nzottmann/postcardscanner-hardware/README.md

## Hardware files for postcardscanner

License: CC-BY-SA-4.0

- 3D CAD, Fusion360 and STEP
- 3D printing files, 3MF
- Hardware BOM
- KiCAD files for custom PCB
- Pictures

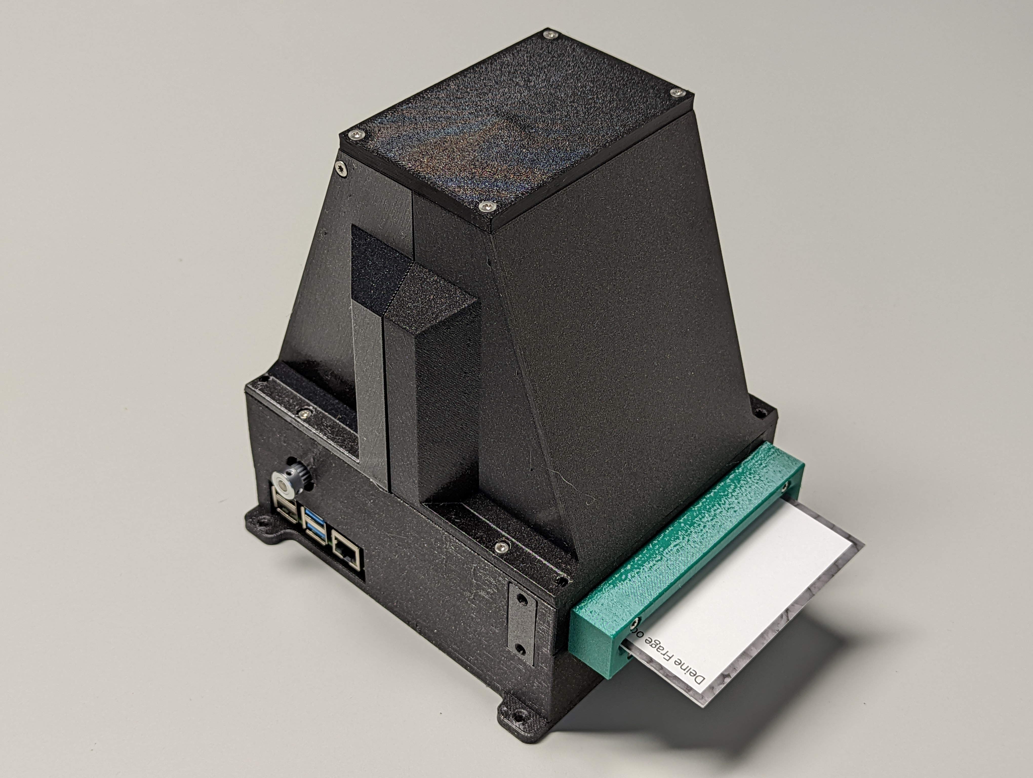
[picture p1: pictures/scanner_17.jpg]
scanner

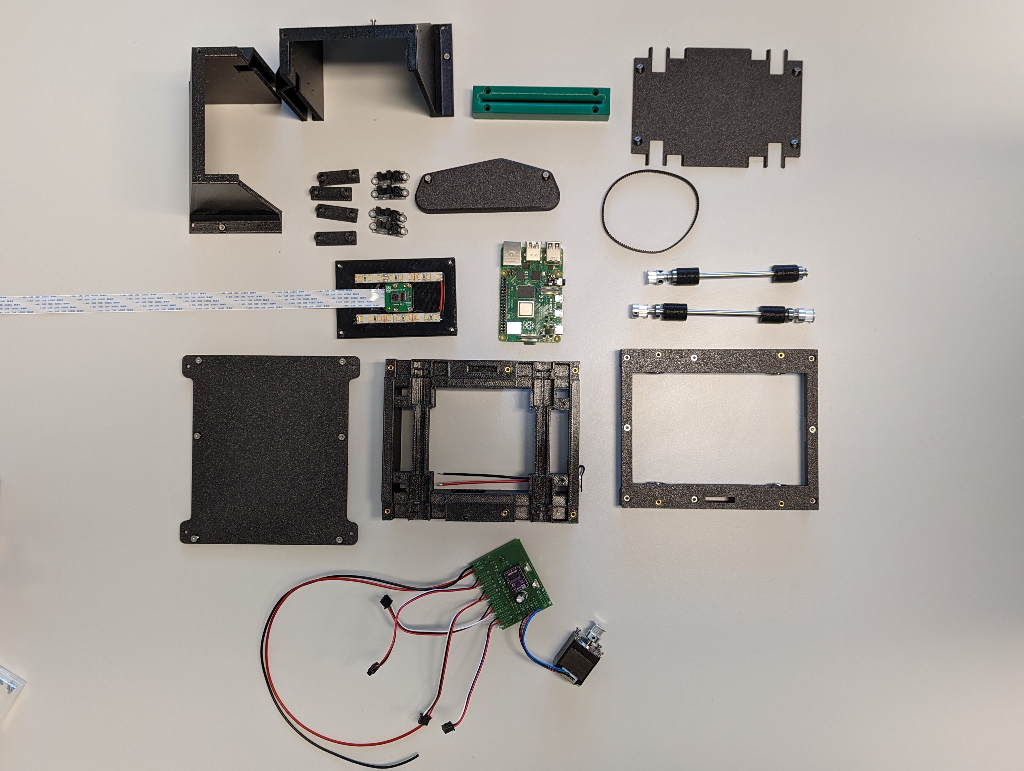
[picture p2: pictures/scanner_01.jpg]
parts
