nzottmann/postcardscanner-hardware/pictures/scanner_02.jpg

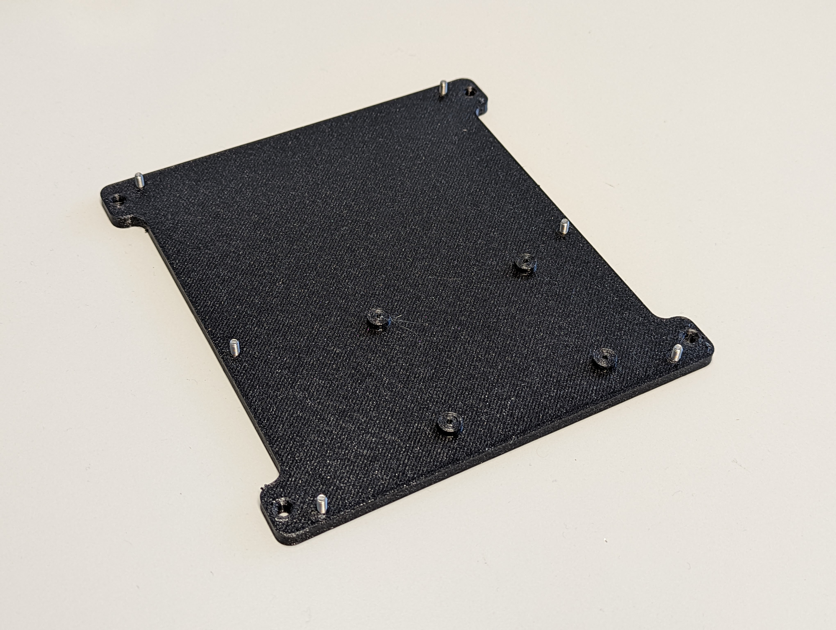
pictures/scanner_02.jpg
