nzottmann/postcardscanner-hardware/pictures/scanner_03.jpg

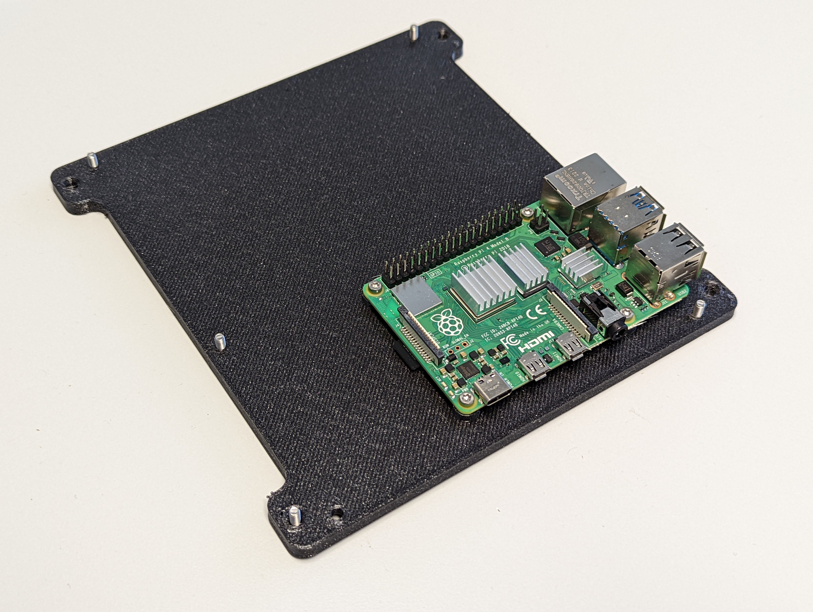
pictures/scanner_03.jpg
