nzottmann/postcardscanner-hardware/pictures/scanner_04.jpg

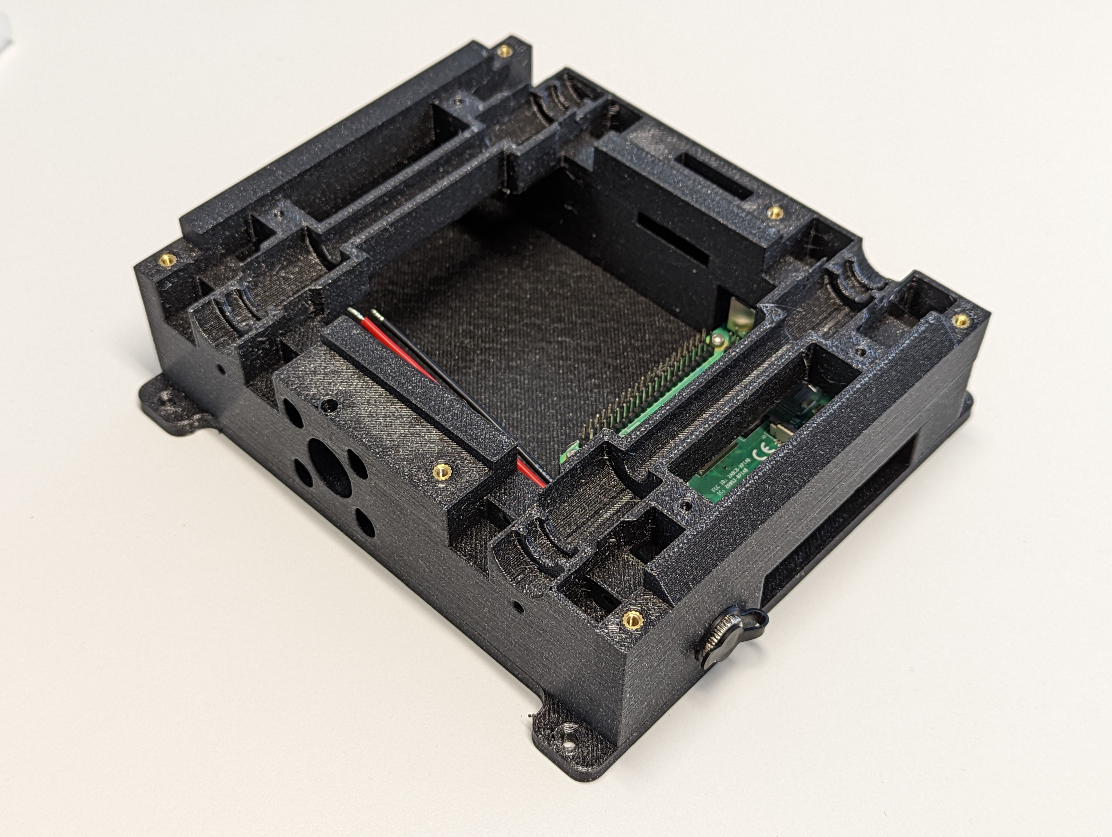
pictures/scanner_04.jpg
