nzottmann/postcardscanner-hardware/pictures/scanner_05.jpg

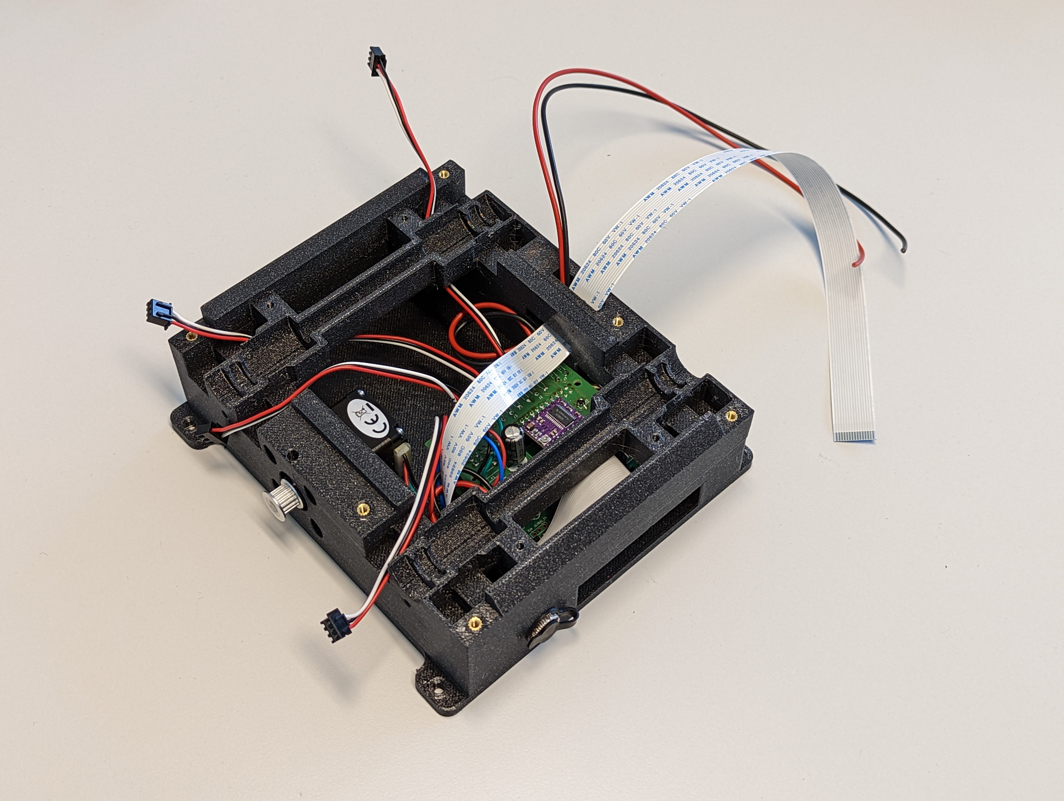
pictures/scanner_05.jpg
