nzottmann/postcardscanner-hardware/pictures/scanner_06.jpg

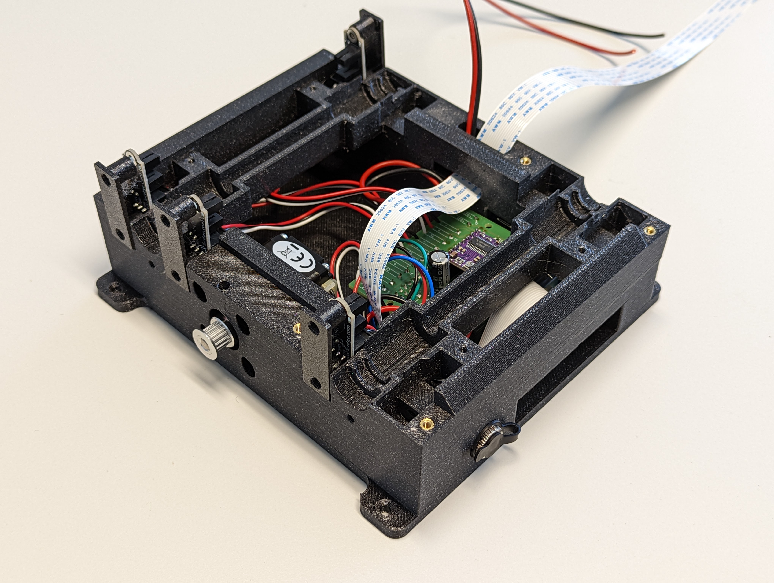
pictures/scanner_06.jpg
