nzottmann/postcardscanner-hardware/pictures/scanner_07.jpg

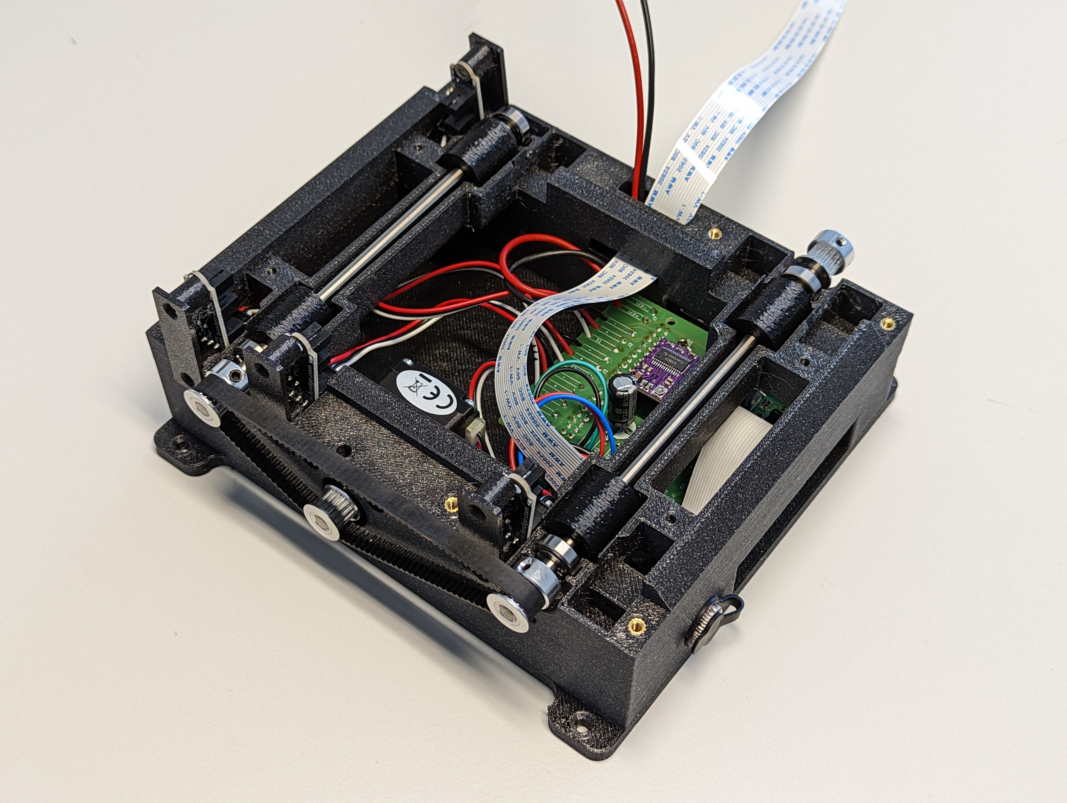
pictures/scanner_07.jpg
