nzottmann/postcardscanner-hardware/pictures/scanner_08.jpg

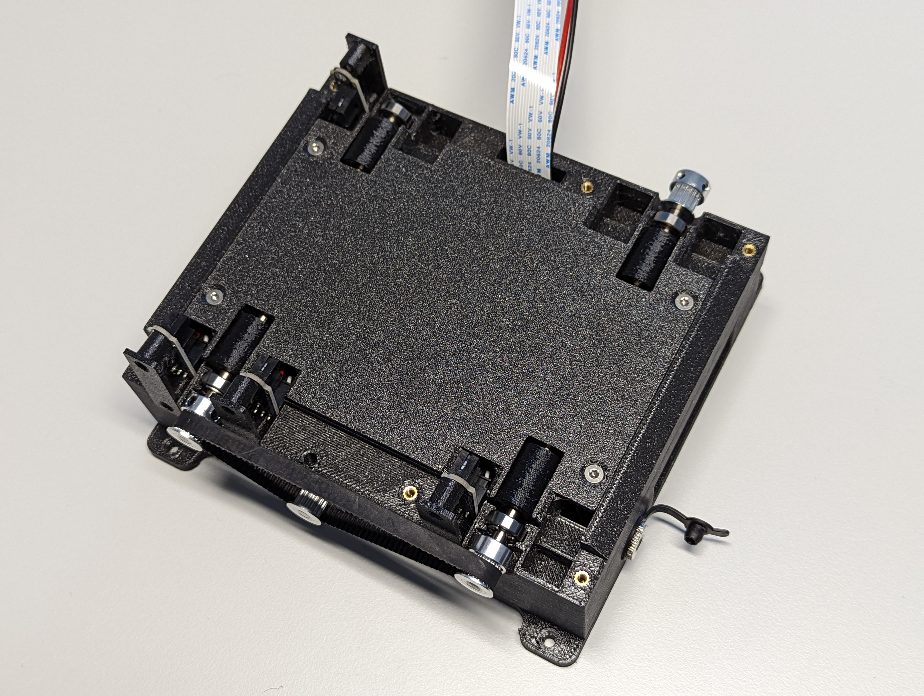
pictures/scanner_08.jpg
