nzottmann/postcardscanner-hardware/pictures/scanner_09.jpg

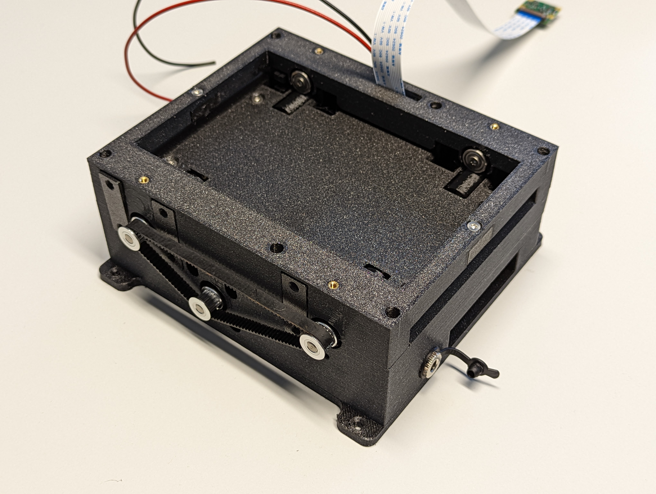
pictures/scanner_09.jpg
