nzottmann/postcardscanner-hardware/pictures/scanner_10.jpg

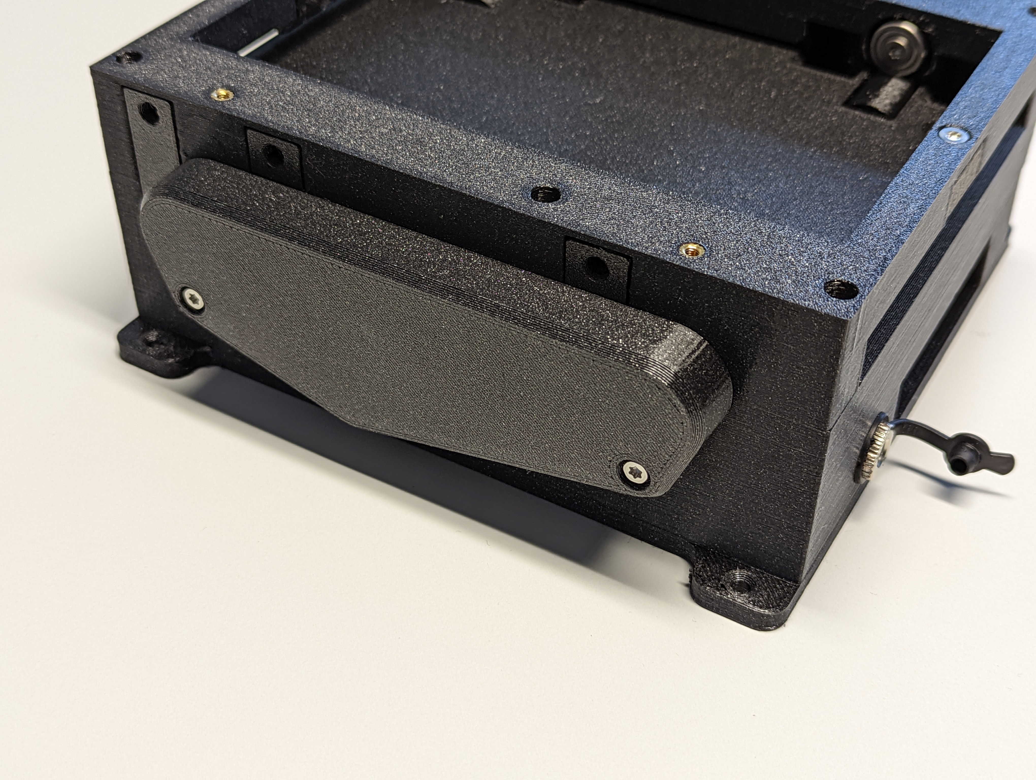
pictures/scanner_10.jpg
