nzottmann/postcardscanner-hardware/pictures/scanner_11.jpg

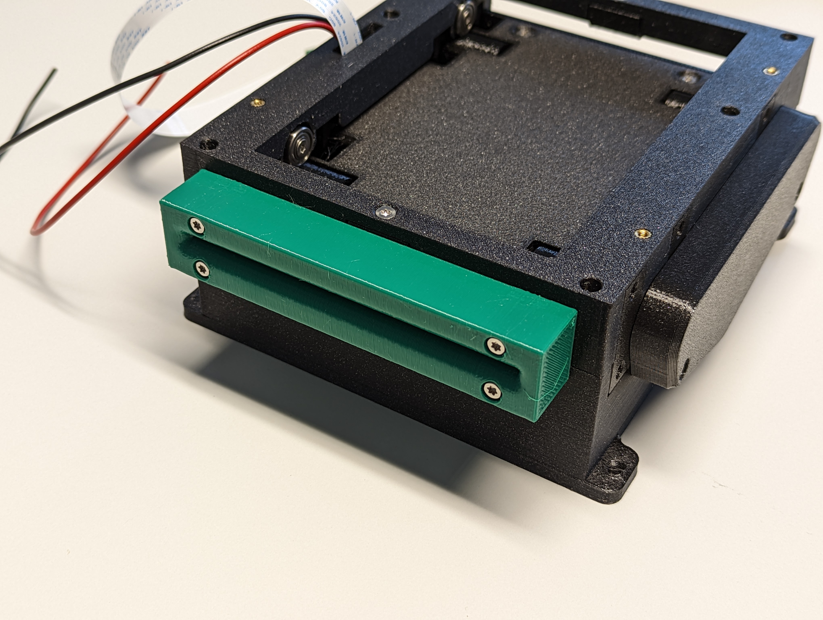
pictures/scanner_11.jpg
