nzottmann/postcardscanner-hardware/pictures/scanner_12.jpg

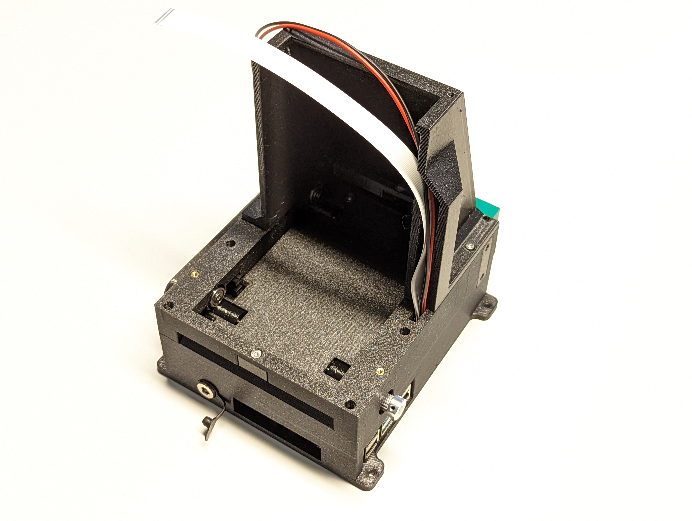
pictures/scanner_12.jpg
