nzottmann/postcardscanner-hardware/pictures/scanner_13.jpg

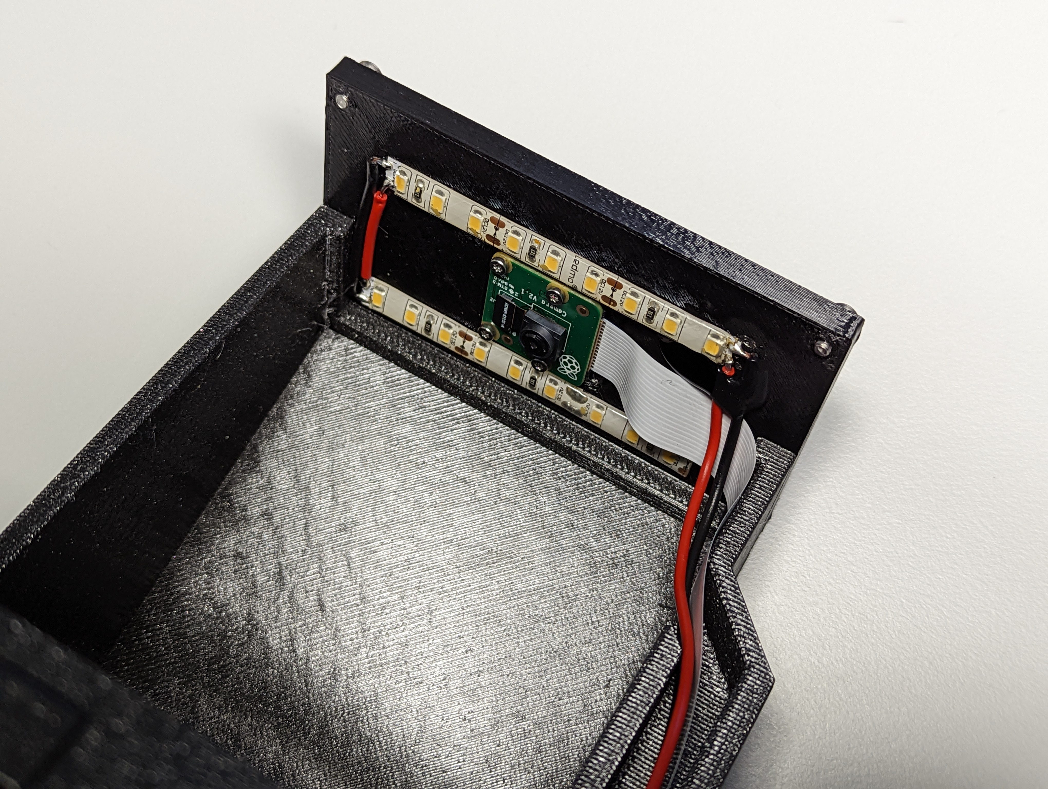
pictures/scanner_13.jpg
