nzottmann/postcardscanner-hardware/pictures/scanner_14.jpg

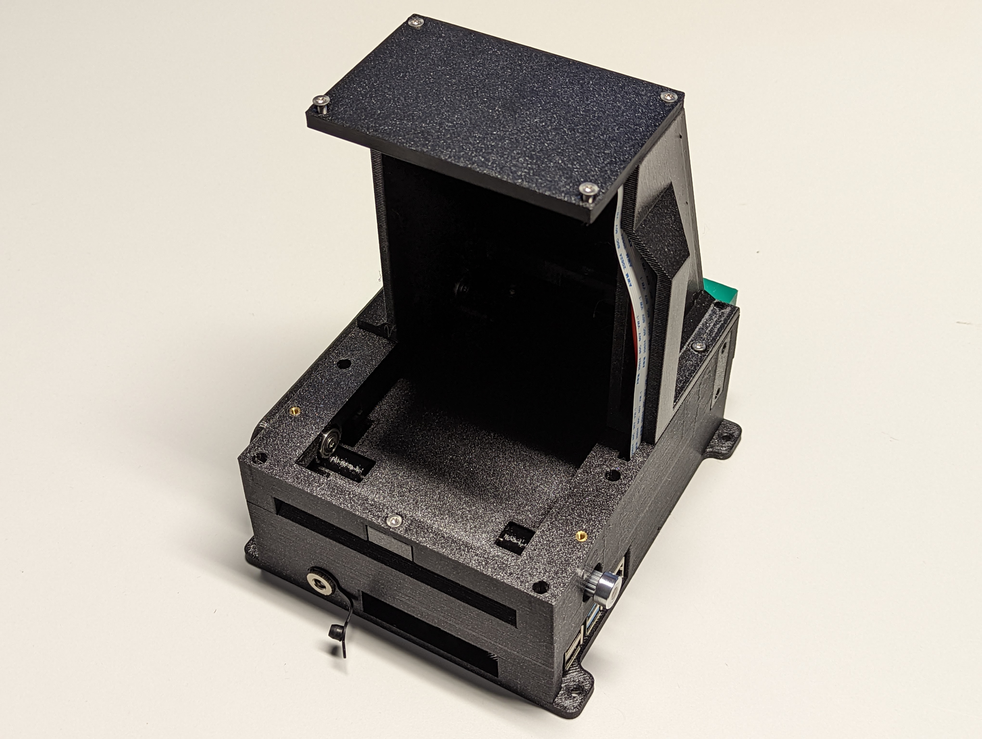
pictures/scanner_14.jpg
