nzottmann/postcardscanner-hardware/pictures/scanner_15.jpg

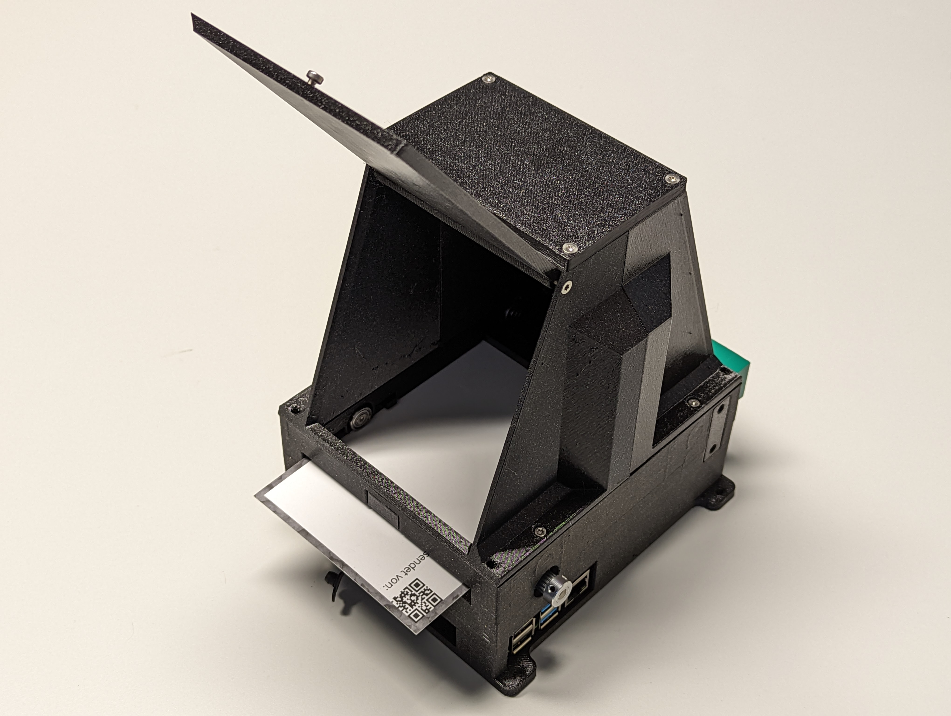
pictures/scanner_15.jpg
