nzottmann/postcardscanner-hardware/pictures/scanner_16.jpg

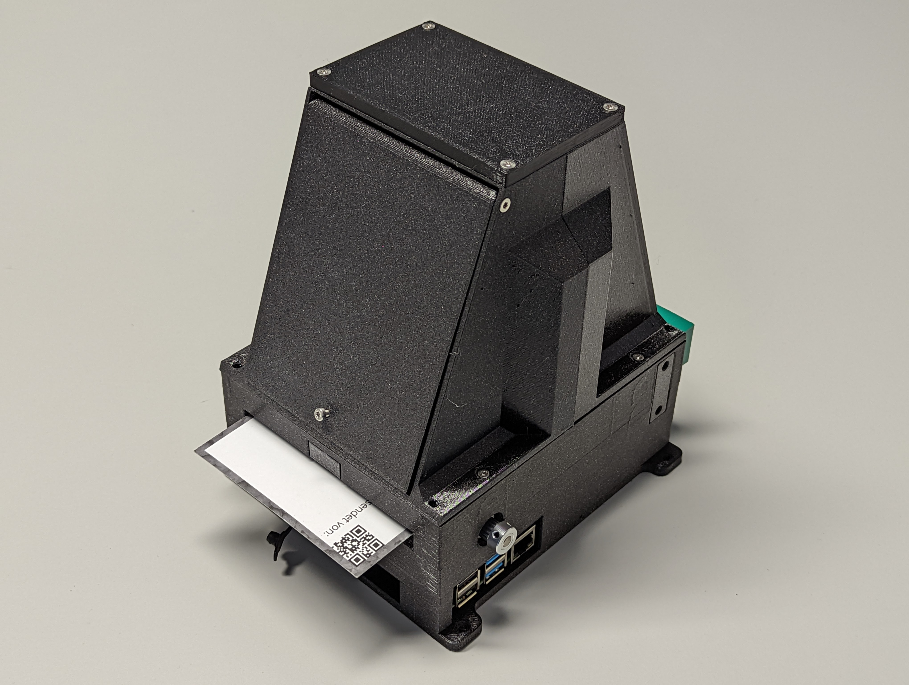
pictures/scanner_16.jpg
