nzottmann/postcardscanner-hardware/hardware/BOM.md

# Postcardscanner Bill of Materials

## 3D printed Parts

For printing, Prusament PETG and a Prusa printer with a 0.6mm nozzle is recommended. Use supports where necessary.

See 3d construction file for placment of these parts:

- base
- frame-bot (needs supports)
- frame-bot-cover
- frame-top
- 4x sensor cover
- feeder
- belt-cover
- camera
  - camera-mount
  - wall-front
  - wall-back
  - wall-back-door
- 4x roller (use TPU, FilaFlexible40 recommended)

## Mechanical

- Misumi
  - 8x bearings 695DD1 13x5x4mm RS/2RS
  - 1x axis PSFMRR5-140-B2-S18.4
  - 1x axis PSFMRR5-156.4-B18.4-S18.4
  - 4x retainer NETWS4
  - 1x belt GBN2502GT-60 2GT 6mm 250mm
- Amazon
  - 4x Pulley GT2 20 teeth for 5mm shaft, 6mm belt
  - Ruthex M3 brass inserts
- stepperonline
  - Nema 11 Bipolar 1.8deg 7Ncm 28x28x31mm
- Screws
  - ISO 14580 TX M2.5 * 6
  - ISO 14580 TX M3 * 6, 10, 16, 20
  - ISO 10642 TX M3 * 6, 10

## Electrical

- Raspberry Pi Camera v2
- Custom connection PCB (see KiCAD files)
- DRV8825 stepper drivers
- Camera flex cable 50cm
- 4x optical endstop
- 12V LED stripe, ~20cm
- Cable
