nzottmann/postcardscanner-hardware/hardware/3d printing/belt-cover.3mf

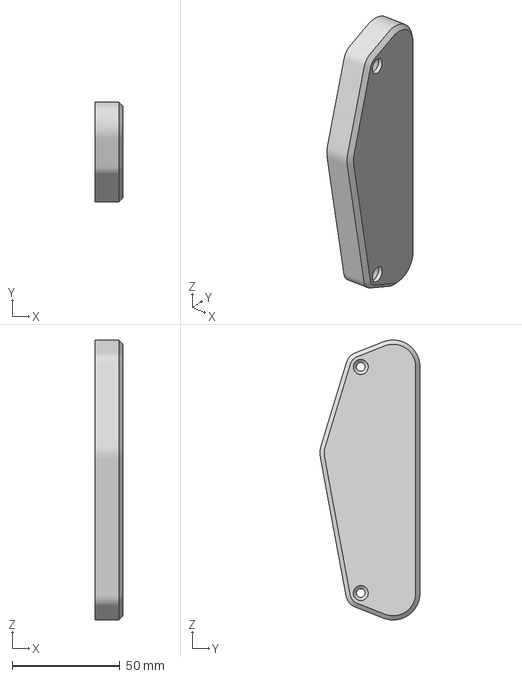
[picture p18: CAD file, 2022-12-04]
hardware/3d printing/belt-cover.3mf
13.2 x 46.4 x 130.0 mm
