nzottmann/postcardscanner-hardware/kicad/postcardscanner.step

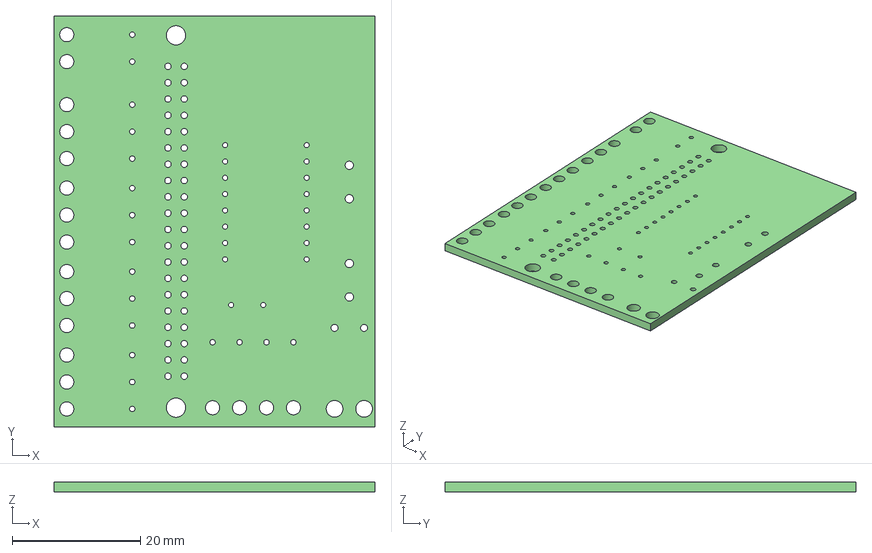
[picture p19: CAD file, 2022-12-04]
kicad/postcardscanner.step
50.0 x 64.0 x 1.60 mm
