nzottmann/postcardscanner-hardware/hardware/3d printing/feeder.3mf

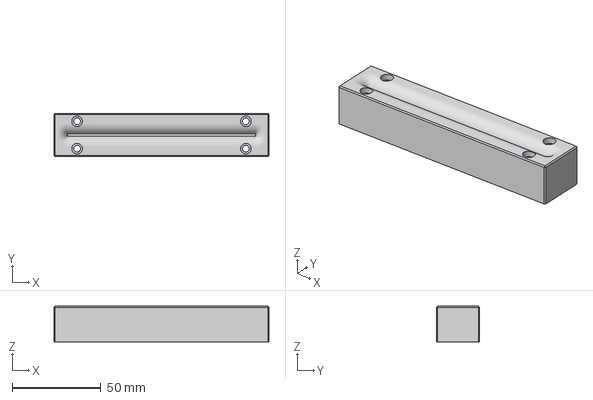
[picture p20: CAD file, 2022-12-04]
hardware/3d printing/feeder.3mf
121.0 x 24.4 x 20.0 mm
