nzottmann/postcardscanner-hardware/hardware/3d printing/roller.3mf

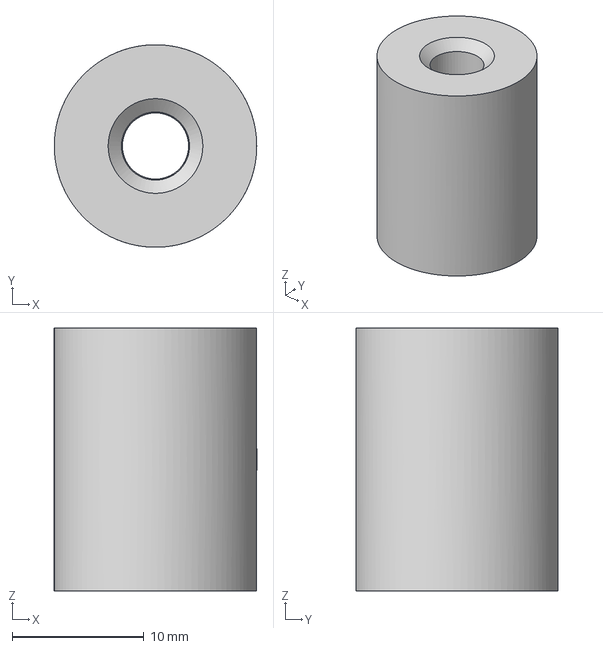
[picture p22: CAD file, 2022-12-04]
hardware/3d printing/roller.3mf
15.4 x 15.4 x 20.0 mm
