nzottmann/postcardscanner-hardware/hardware/3d printing/wall-back-door.3mf

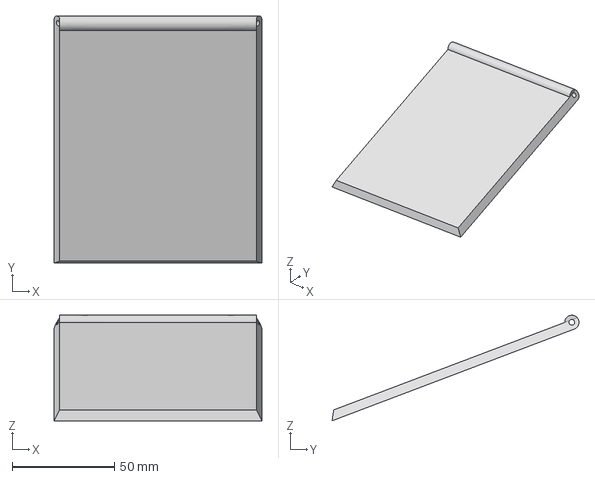
[picture p23: CAD file, 2022-12-04]
hardware/3d printing/wall-back-door.3mf
101.7 x 120.8 x 51.7 mm
