nzottmann/postcardscanner-hardware/hardware/3d printing/frame-bot.3mf

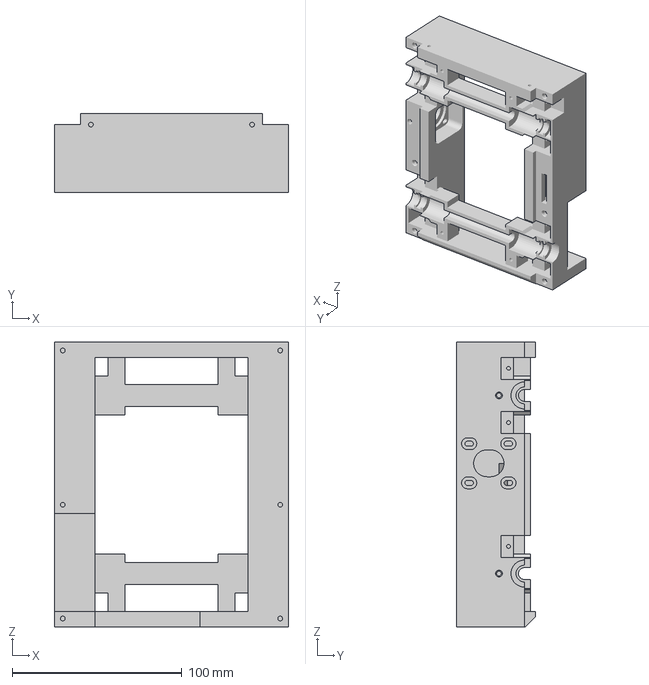
[picture p24: CAD file, 2022-12-04]
hardware/3d printing/frame-bot.3mf
138.2 x 46.5 x 168.0 mm
