nzottmann/postcardscanner-hardware/hardware/3d printing/frame-bot-cover.3mf

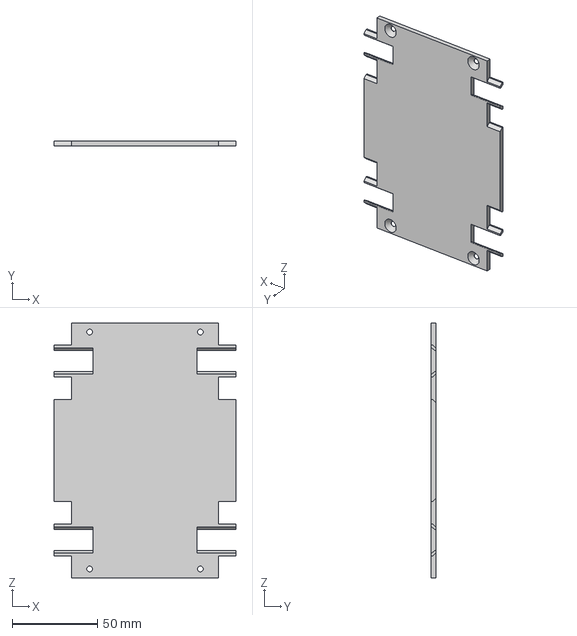
[picture p25: CAD file, 2022-12-04]
hardware/3d printing/frame-bot-cover.3mf
106.6 x 3.00 x 149.6 mm
