nzottmann/postcardscanner-hardware/hardware/3d printing/camera-mount.3mf

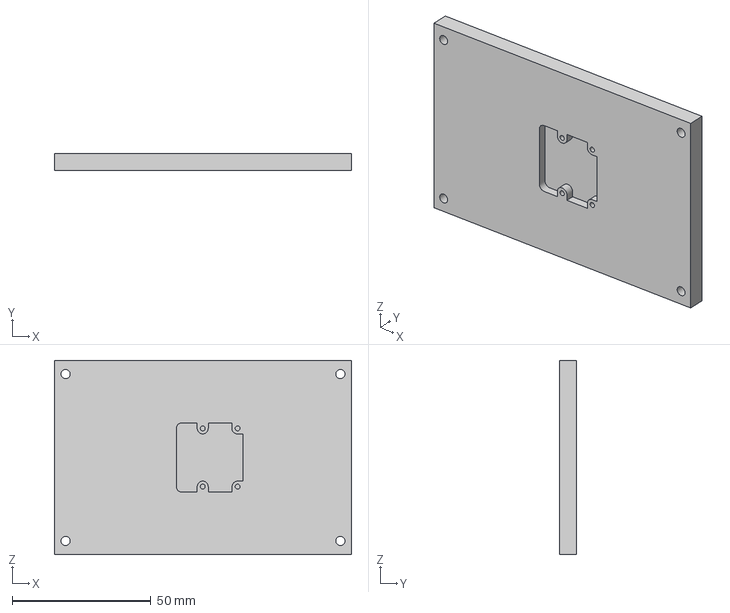
[picture p26: CAD file, 2022-12-04]
hardware/3d printing/camera-mount.3mf
107.0 x 6.00 x 70.0 mm
