nzottmann/postcardscanner-hardware/hardware/3d printing/wall-front.3mf

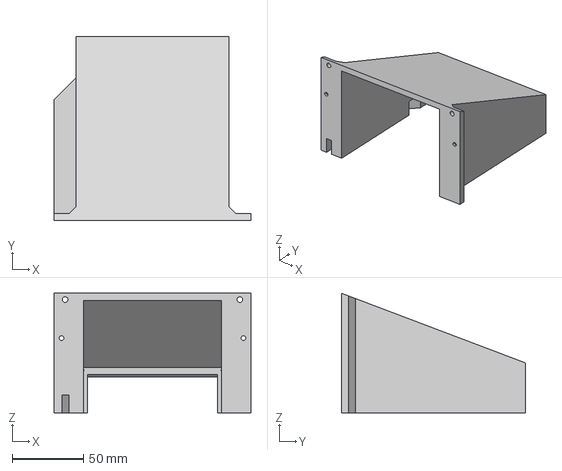
[picture p27: CAD file, 2022-12-04]
hardware/3d printing/wall-front.3mf
138.2 x 129.4 x 84.0 mm
