nzottmann/postcardscanner-hardware/hardware/3d printing/sensor-cover.3mf

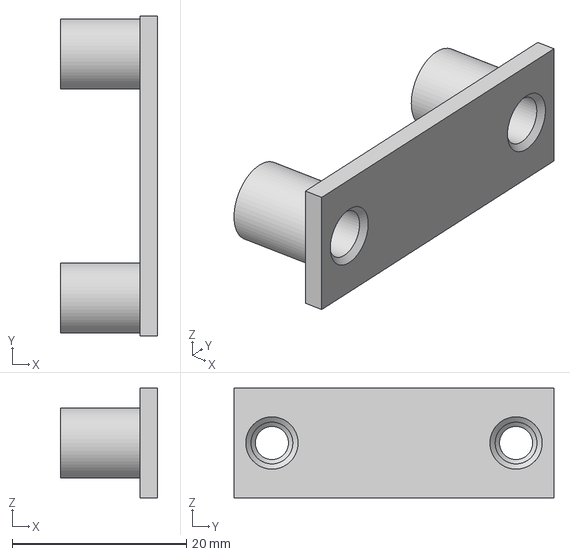
[picture p28: CAD file, 2022-12-04]
hardware/3d printing/sensor-cover.3mf
11.1 x 36.7 x 12.6 mm
