nzottmann/postcardscanner-hardware/hardware/3d printing/base.3mf

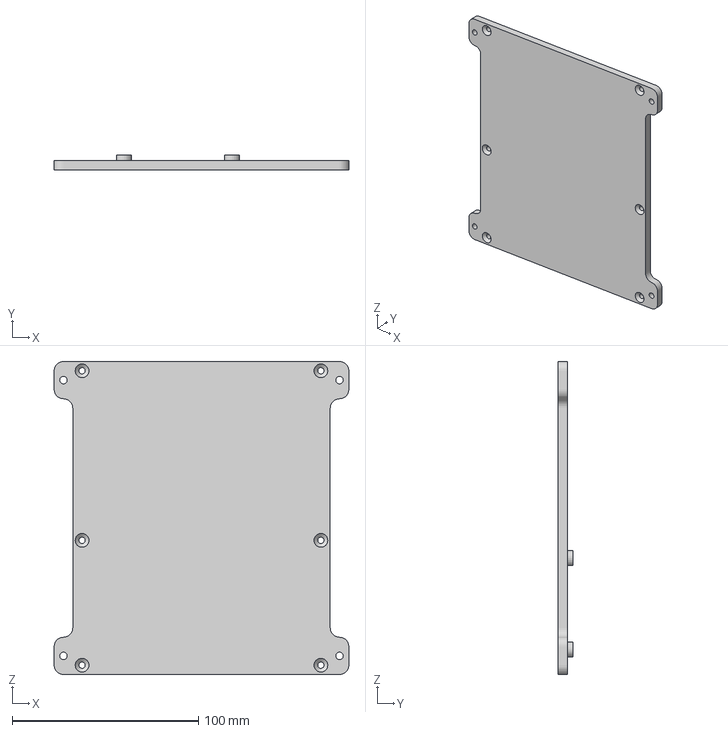
[picture p29: CAD file, 2022-12-04]
hardware/3d printing/base.3mf
158.2 x 8.01 x 168.0 mm
