nzottmann/postcardscanner-hardware/hardware/3d printing/frame-top.3mf

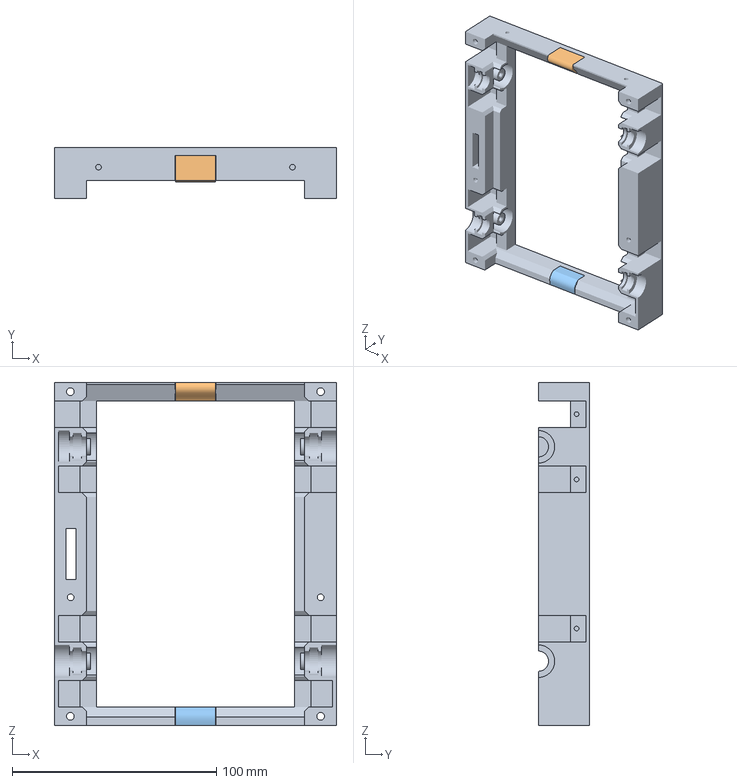
[picture p30: CAD file, 2022-12-04]
hardware/3d printing/frame-top.3mf
138.2 x 25.0 x 168.0 mm
Körper1 x 3
