nzottmann/postcardscanner-hardware/kicad/postcardscanner.kicad_pcb

## KiCad design kicad/postcardscanner.kicad_pcb (2022-12-04)

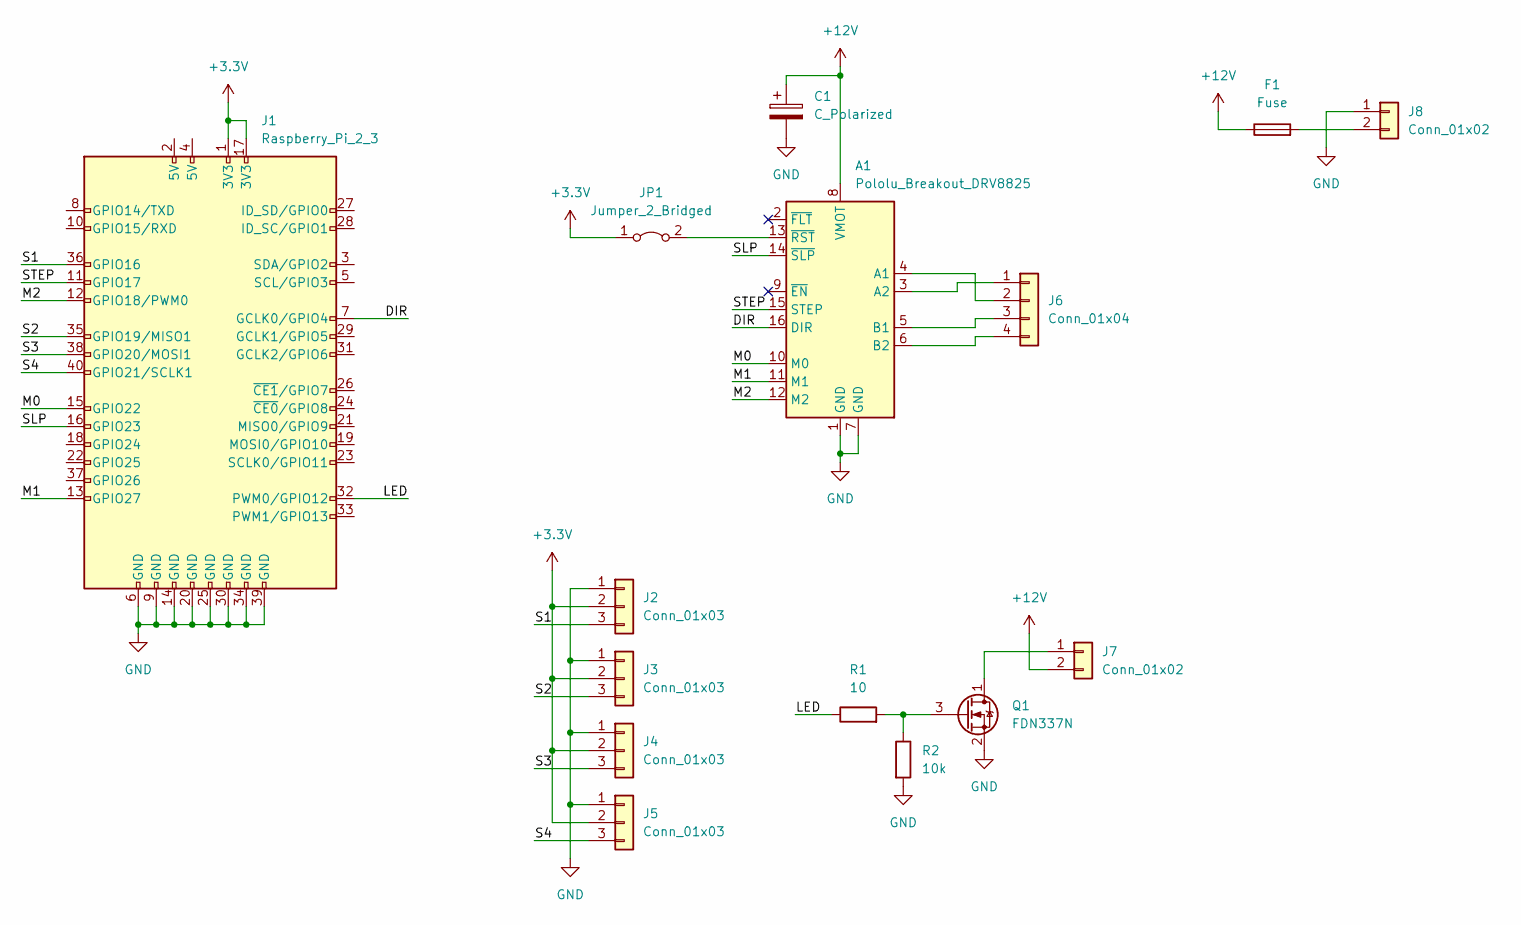
[picture p31: schematic postcardscanner.kicad_sch]

Parts:
A1: Pololu_Breakout_DRV8825; Pololu_Breakout-16_15.2x20.3mm
C1: C_Polarized; CP_Radial_D8.0mm_P5.00mm
F1: Fuse; Fuseholder_Littelfuse_445_030_series_5x20mm
J1: Raspberry_Pi_2_3; PinSocket_2x20_P2.54mm_Vertical
J2, J3, J4, J5: Conn_01x03; SolderWire-0.25sqmm_1x03_P4.2mm_D0.65mm_OD1.7mm_Relief
J6: Conn_01x04; SolderWire-0.25sqmm_1x04_P4.2mm_D0.65mm_OD1.7mm_Relief
J7: Conn_01x02; SolderWire-0.25sqmm_1x02_P4.2mm_D0.65mm_OD1.7mm_Relief
J8: Conn_01x02; SolderWire-0.5sqmm_1x02_P4.6mm_D0.9mm_OD2.1mm_Relief
JP1: Jumper_2_Bridged; SolderJumper-2_P1.3mm_Bridged_RoundedPad1.0x1.5mm
Q1: FDN337N; SOT-23_Handsoldering
R1: 10; R_0603_1608Metric_Pad0.98x0.95mm_HandSolder
R2: 10k; R_0603_1608Metric_Pad0.98x0.95mm_HandSolder

Connections:
+3.3V: J1.1 (3V3), J1.17 (3V3), J2.2, J3.2, J4.2, J5.2, JP1.1 (A)
+12V: A1.8 (VMOT), C1.1, F1.1, J7.2
/DIR: A1.16 (DIR), J1.7 (GCLK0/GPIO4)
/LED: J1.32 (PWM0/GPIO12), R1.1
/M0: A1.10 (M0), J1.15 (GPIO22)
/M1: A1.11 (M1), J1.13 (GPIO27)
/M2: A1.12 (M2), J1.12 (GPIO18/PWM0)
/S1: J1.36 (GPIO16), J2.3
/S2: J1.35 (GPIO19/MISO1), J3.3
/S3: J1.38 (GPIO20/MOSI1), J4.3
/S4: J1.40 (GPIO21/SCLK1), J5.3
/SLP: A1.14 (~SLP), J1.16 (GPIO23)
/STEP: A1.15 (STEP), J1.11 (GPIO17)
GND: A1.1 (GND), A1.7 (GND), C1.2, J1.6 (GND), J1.9 (GND), J1.14 (GND), J1.20 (GND), J1.25 (GND), J1.30 (GND), J1.34 (GND), J1.39 (GND), J2.1, J3.1, J4.1, J5.1, J8.1, Q1.2 (S), R2.2
unnamed: A1.3 (A2), J6.1
unnamed: A1.4 (A1), J6.2
unnamed: A1.5 (B1), J6.3
unnamed: A1.6 (B2), J6.4
unnamed: A1.13 (~RST), JP1.2 (B)
unnamed: F1.2, J8.2
unnamed: J7.1, Q1.1 (D)
unnamed: Q1.3 (G), R1.2, R2.1

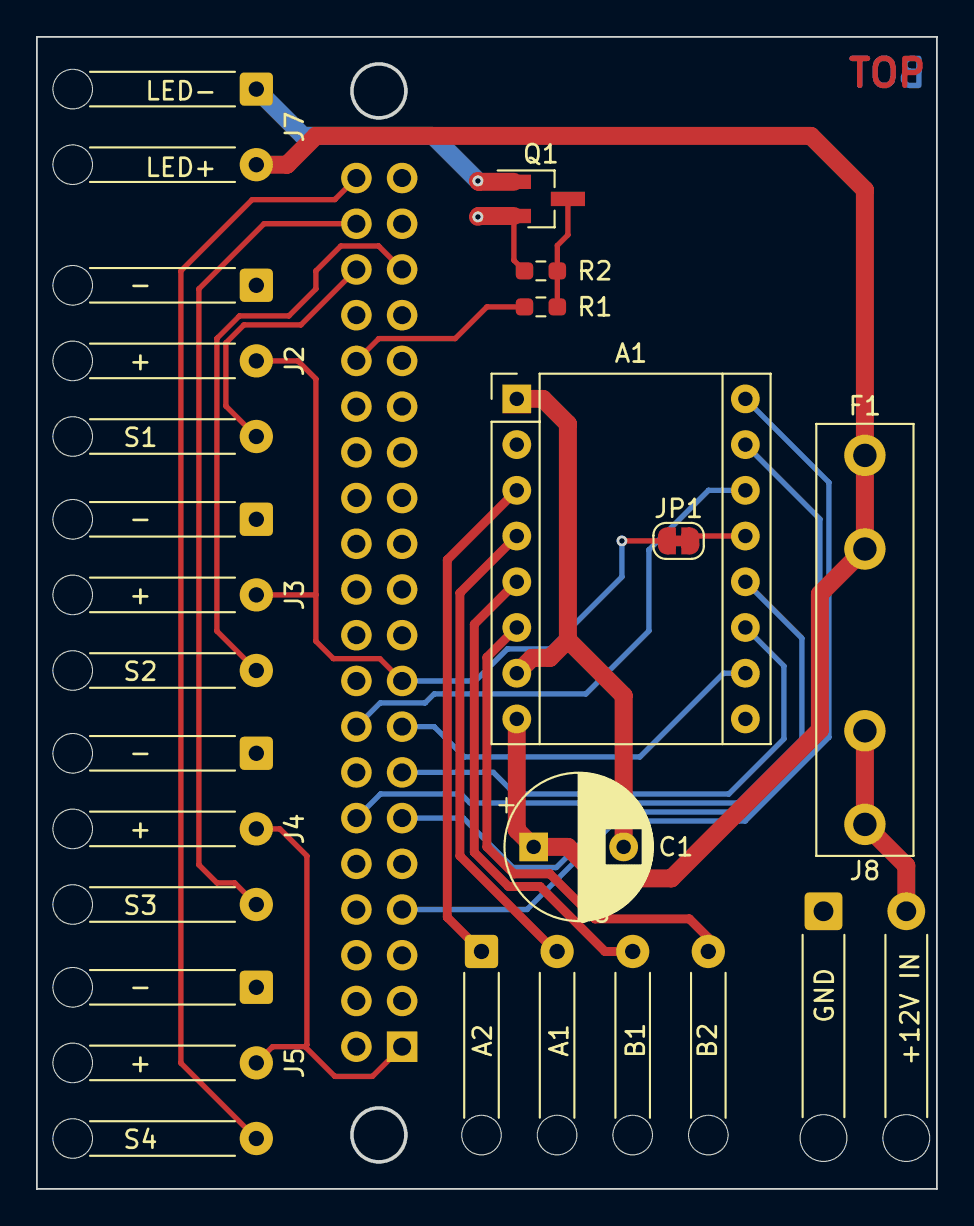
[picture p32: board postcardscanner.kicad_pcb from above]

Board: 2 copper layers, 50.0 x 64.0 mm, 15 parts (1 on the bottom side), 22 nets.
